edosedgar/ATX_PS/БЛок схема программы.docx

Да

Подключен

аккумулятор?

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
Вывод проблемы

Вариант решения

Выбор мощности

Нажата любая кнопка?

Процент нагрузки максимальный?

Есть отклонения

напряжений?

Увеличить ток

PowerGood OK?

Напряжения ОК?

Сопротивление ОК?

+5 VSB ОК?

Сеть?

Заряжен?

Инициализация
