edosedgar/ATX_PS/Назначение портов.docx

Порт | Назначение
PA10 | PWM12v
PA9 | PWM5v
PA8 | PWM3v3
PA13 | SWDIO
PA14 | SWCLK
PB3 | «OK»
PB5 | «C»
PB6 | LCD_DB4
PB15 | LCD_DB5
PC6 | LCD_DB6
PC7 | LCD_DB7
PB8 | LCD_E
PB9 | LCD_RS
PB11 | UART3_RX
PB10 | UART3_TX
PB0 | BUZZER
PC0 | POWER
PC1 | Current3v3
PC2 | Current5v
PC3 | Current12v
PA0 | PowerGood
PA1 | Volt3v3
PA2 | Volt5v
PA3 | Volt12v
PA4 | StandBy5v
PA5 | PowerON
PA6 | Resistance3v3
PA7 | Resistance12v
PC4 | Resistance5v
PC5 | ReleON
