edosedgar/ATX_PS/Список деталей.docx

№ | Наименование | Стоимость (руб.) | Кол-во (шт.) | Сумма (руб.)
1. | Аккумулятор 12V 0.8A DJW12-0.8 | 470.00 | 1 | 470.00
2. | Аккумулятор ROBITON 12V 0.8A VRLA 1208 | 400.00 | 0 | 0.00
3. | Микросхема ACS712ELCTR-20A-T | 0.00 | 3 | 300.00
4. | Оптрон PC817 C | 8.00 | 4 | 32.00
5. | Транзистор IRLML2502TR smd | 7.00 | 5 | 35.00
6. | Микросхема STM32F100RCT6 smd | 185.00 | 1 | 185.00
7. | Резистор 15Вт 4.7 Ом SQP керамика | 15.00 | 5 | 75.00
8. | Резистор 10Вт 3.3 Ом SQP керамика | 15.00 | 4 | 60.00
9. | Резистор 10Вт 0.99 Ом SQZD керамика | 20.00 | 3 | 60.00
10. | Резистор 5Вт 5.1 Ом SQP керамика | 10.00 | 1 | 10.00
11. | Микросхема FT232BM(BL) smd | 275.00 | 1 | 275.00
12. | Гнездо USBB-1J на плату | 10.00 | 1 | 10.00
13. | Дисплей WG12864 | 650.00 | 1 | 650.00
14. | Кварц 8.0 МГц | 7.00 | 1 | 7.00
15. | Резистор 5Вт 10 Ом SQP керамика | 10.00 | 1 | 10.00
16. | Резистор 5Вт 75 Ом SQP керамика | 15.00 | 1 | 15.00
17. | Резистор 5Вт 39 Ом SQP керамика | 10.00 | 3 | 30.00
18. | Резистор 5Вт 18 Ом SQP керамика | 10.00 | 2 | 20.00
19. | Резистор 5Вт 27 Ом SQP керамика | 15.00 | 1 | 15.00
20. | Транзистор IRFZ44NPBF 60V 50A | 25.00 | 3 | 75.00
21. | Кварц 6.0 МГц усеченный | 15.00 | 1 | 15.00

ИТОГО: 2349.00 руб.

Стеклотекстолит 1-х 200*150 | 60.00 | 2 шт.
Припой ПОС-61 0.8мм 100г без канифоли | 180.00 | 1 шт.
Припой Сплав РОЗЕ 100г | 180.00 | 1 шт.
