edosedgar/ATX_PS/Автоматизированное устройство для тестирования компьютерных блоков питания.pptx

## «Разработка автоматизированного устройства диагностики и тестирования компьютерных блоков питания»

Автор:
Казиахмедов Эдгар Арсенович
Научный руководитель:
Овчинников Владимир Викторович

## Не включается компьютер?

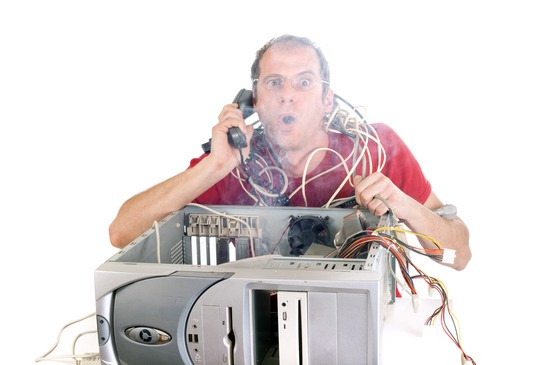
[picture p1: figure]

## Выбросить нельзя, ремонтировать!

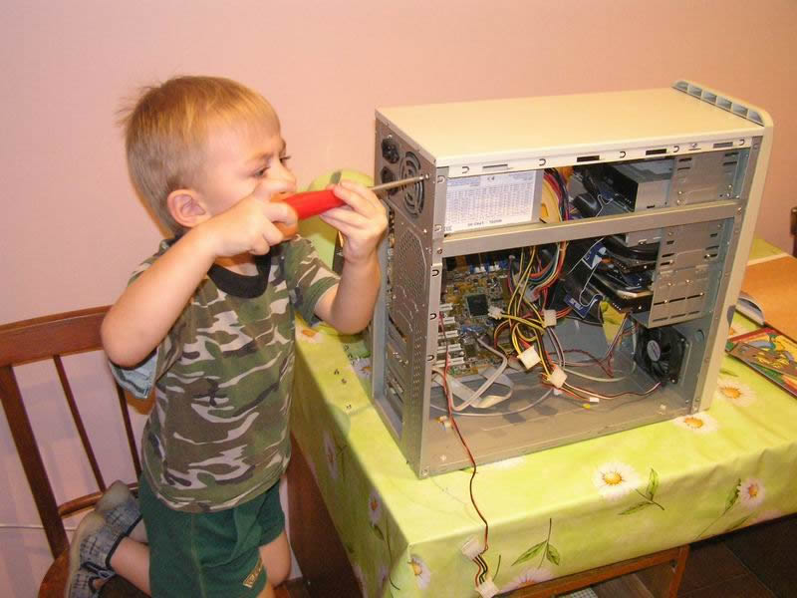
[picture p2: figure]

## Автоматизация ремонта

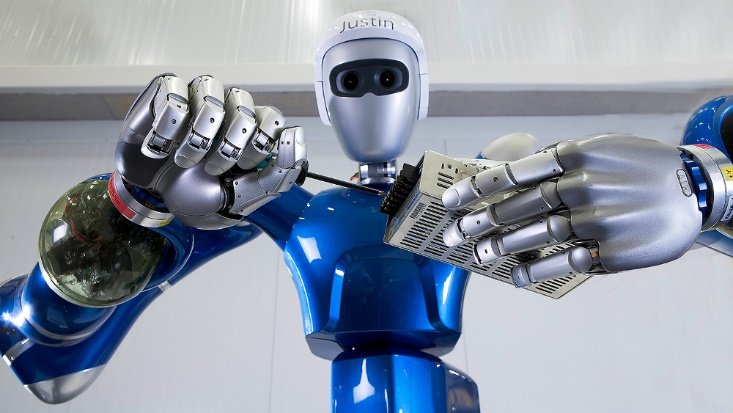
[picture p3: figure]
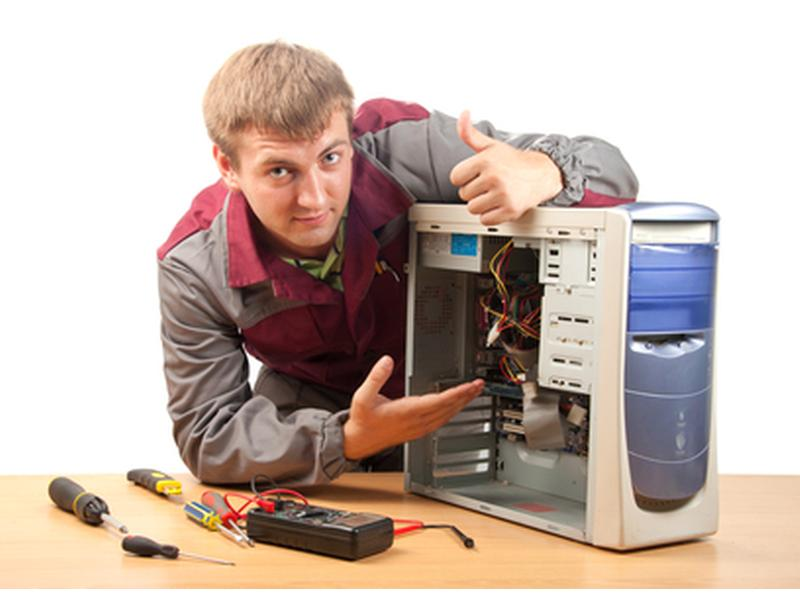
[picture p4: figure]

## Цель

- разработка комплексного устройства, которое сможет в автоматическом режиме провести полную доступную диагностику компьютерного блока питания, выявить его возможные неполадки, а также выполнить тестирование нагрузочной способности.

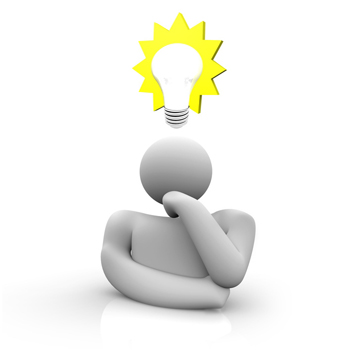
[picture p5: figure]

## Виды неисправностей

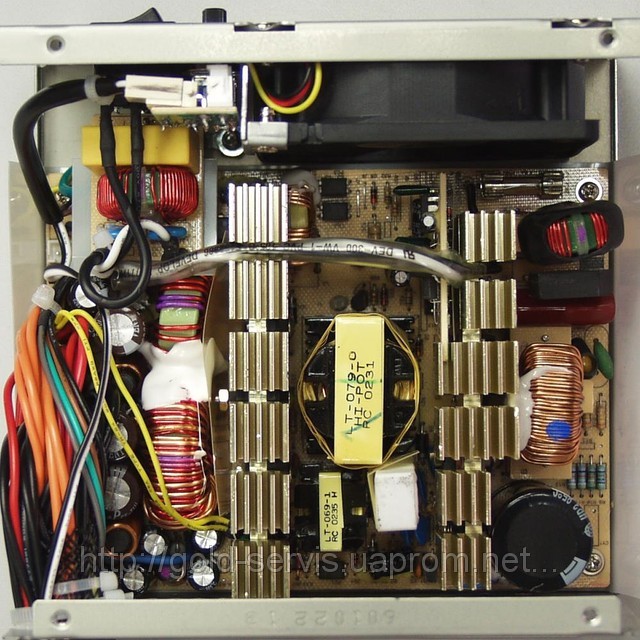
[picture p6: figure]

- Пробой диода
- Высыхание электролитов
- Отклонение напряжений
- Неисправность дежурного питания
- Неисправность в управляющих цепях

## Функциональная схема

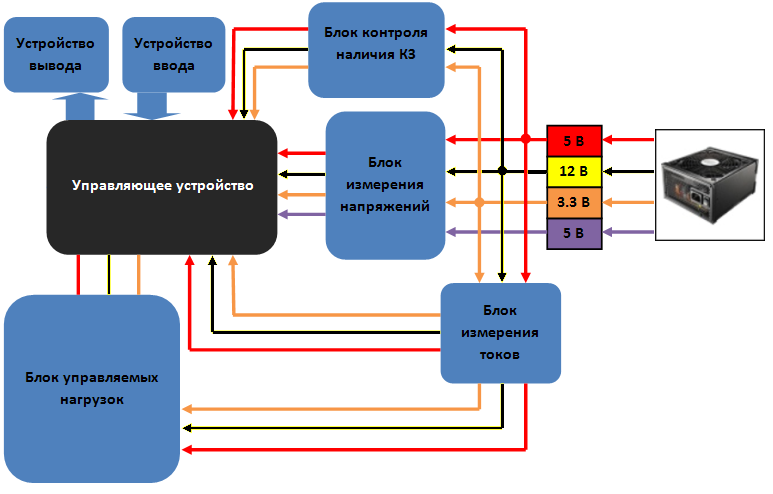
[picture p7: figure]

## Электронная нагрузка

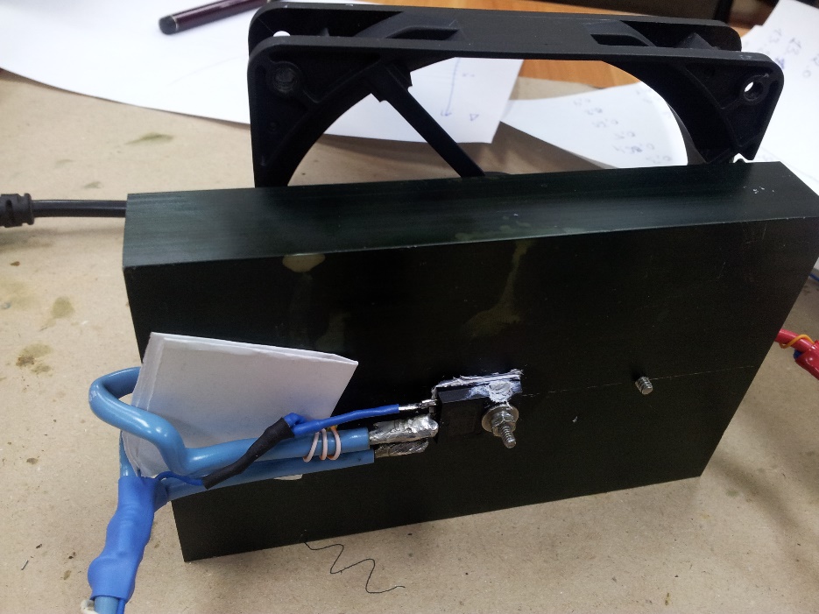
[picture p8: figure]

- Нагрузка на каналы 3,3 В и 5 В:
- Полевые транзисторы IRFZ24N и IRFZ46N
- Рассеиваемая мощность 107 Вт

- Нагрузка на канал 12 В:
- 2 полевых транзистора IRFP064N
- Рассеиваемая мощность 170 Вт

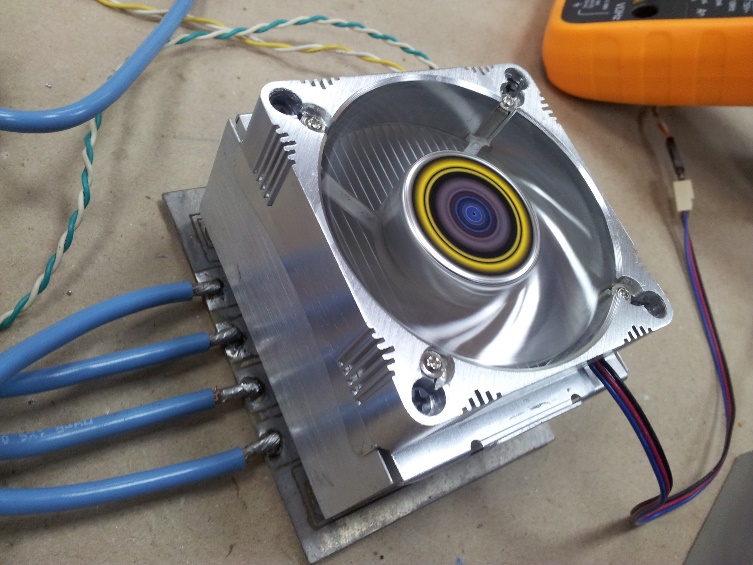
[picture p9: figure]

## Обратная связь

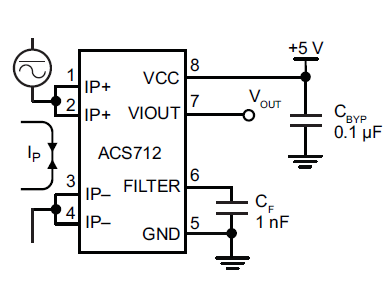
[picture p10: figure]
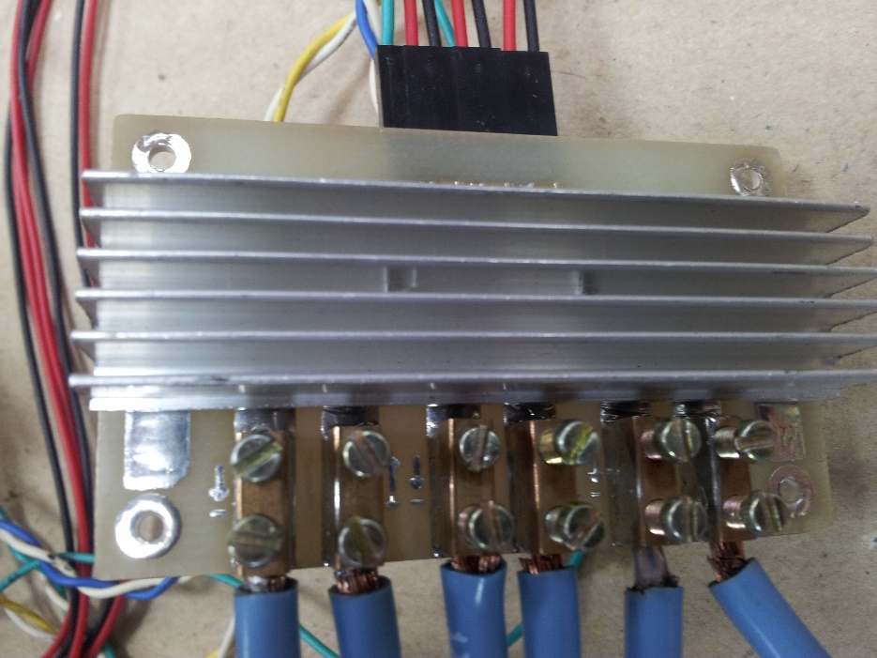
[picture p11: figure]

## Управляющее устройство

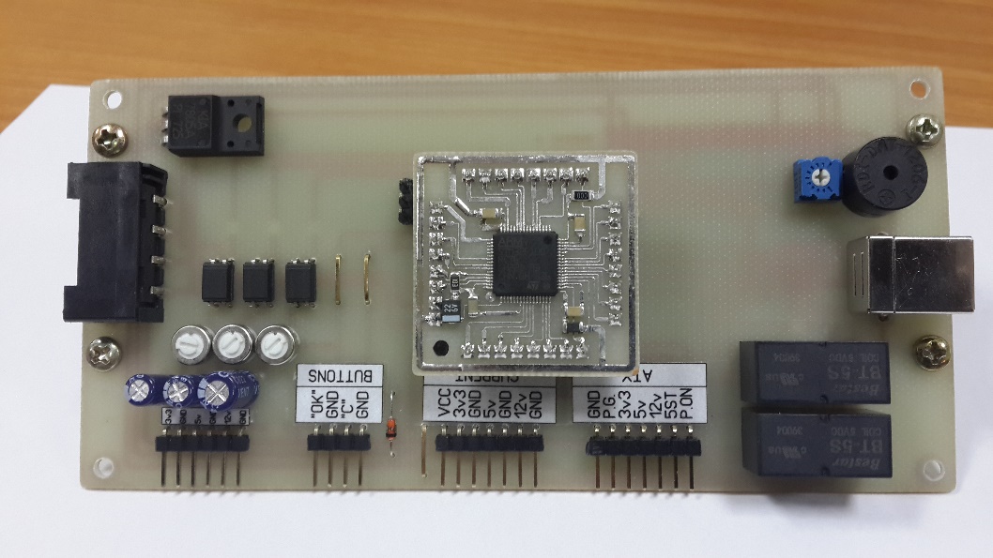
[picture p12: figure]

- Пьезоизлучатель
- ШИМ фильтр
- Разъемы для подключения внешних модулей

- Микроконтроллер STM32F100RC
- Преобразователь USB->USART

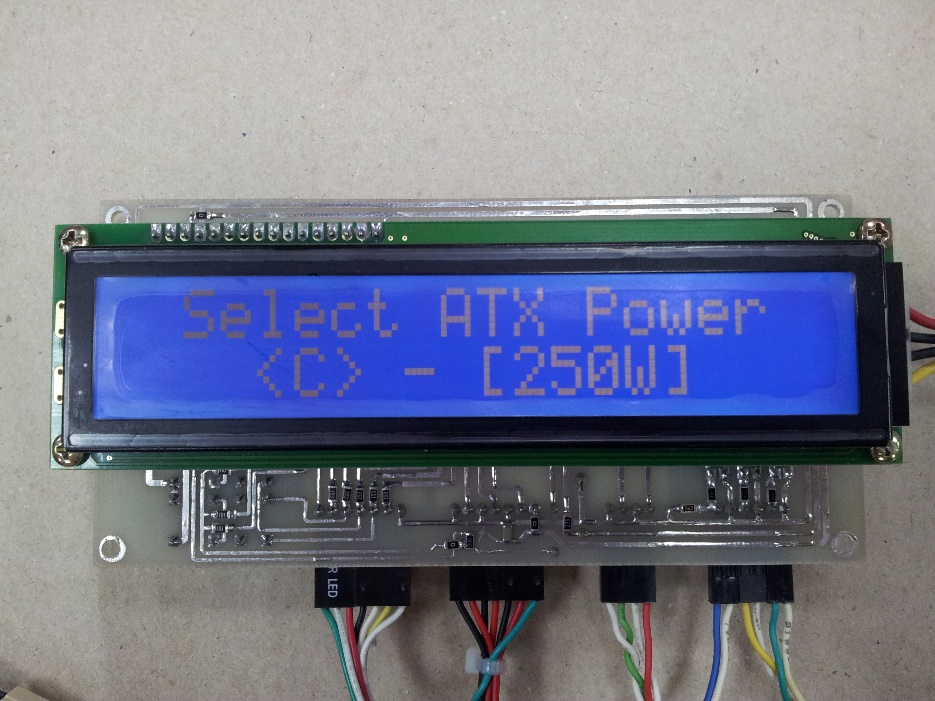
[picture p13: figure]

## Преимущества

- Отсутствии необходимости вмешательства пользователя в процесс тестирования
- Эффективная методика диагностики
- Автономное питание
- Быстрое получение результата

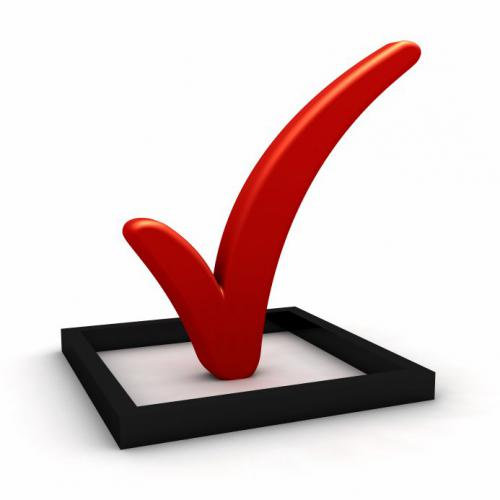
[picture p14: figure]

## Итог

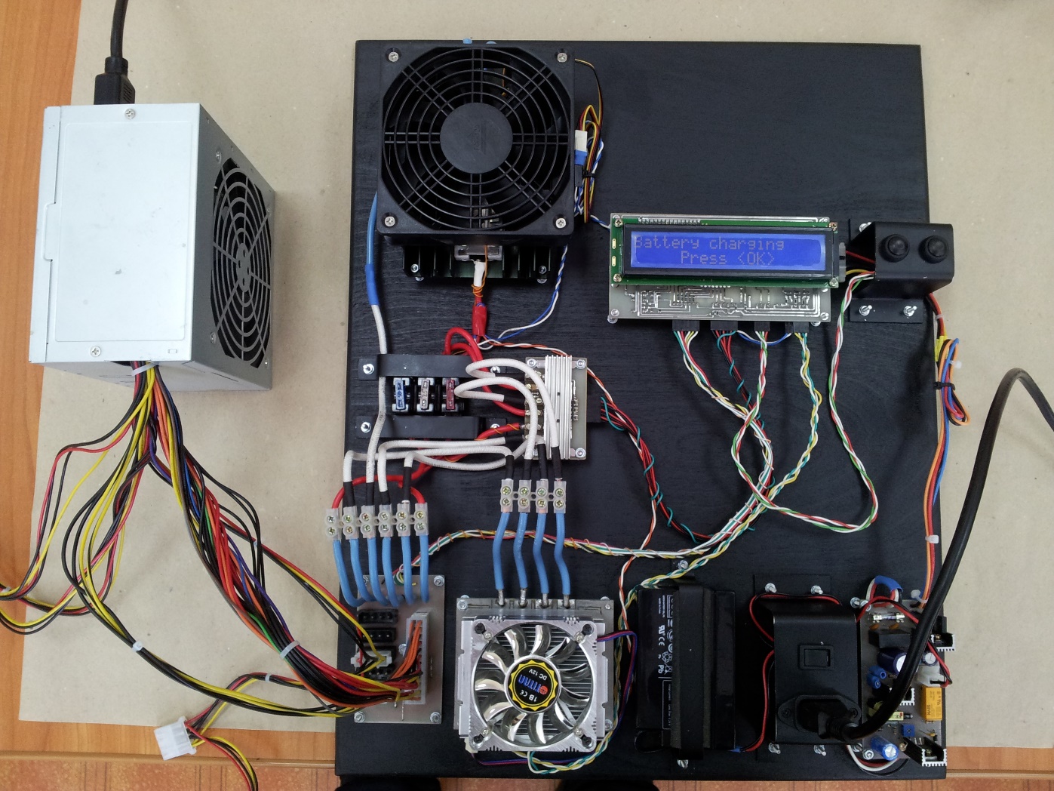
[picture p15: figure]

## Доработка и модернизация

- Реализация возможности загрузки микропрограммы через USB
- Автоматическое отключение питания при разрядке аккумулятора
- Исправление ошибки в схемотехническом решении в цепи управления PowerON
- Улучшение параметров электронных нагрузок

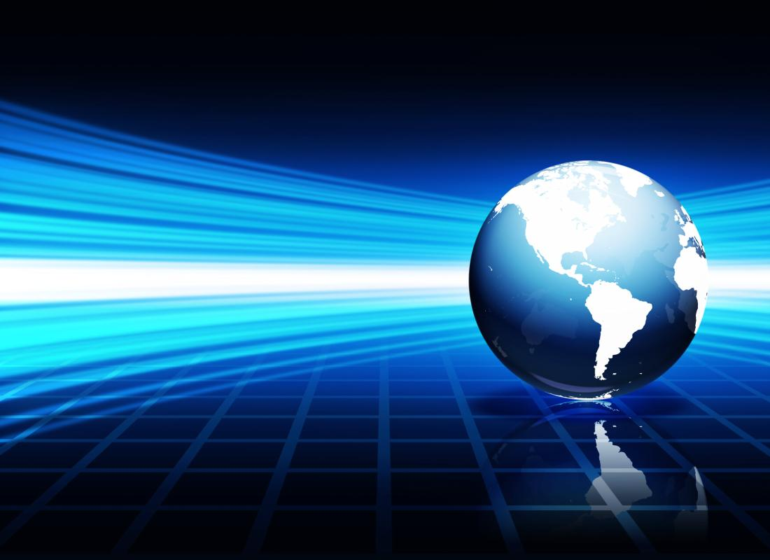
[picture p16: figure]
