edosedgar/ATX_PS/Наклейки на стенд.docx

OK C

БЛОК ПРЕДОХРАНИТЕЛЕЙ

ЭЛЕКТРОННЫЕ НАГРУЗКИ 3,3 В, 5 В

БЕСПЕРЕБОЙНЫЙ ИСТОЧНИК ПИТАНИЯ

УСТРОЙСТВО ВВОДА

УПРАВЛЯЮЩЕЕ УСТРОЙСТВО

ЭЛЕКТРОННАЯ НАГРУЗКА 12 В

БЛОК ИЗМЕРЕНИЯ СИЛЫ ТОКА

«Автоматизированное устройство диагностики и тестирования компьютерных блоков питания»

Автор: Казиахмедов Эдгар Арсенович, 17 лет

Руководитель: Овчинников Владимир Викторович

Учреждение: МБОУДОД ДДЮТ г. Тольятти
