edosedgar/ATX_PS/(list of files, drawings)

Other design files:
PCB/5V; 3,3V channels.lay6
PCB/ACS712.lay6
PCB/ATXBoard.lay6
PCB/GeneralBoard.lay6
PCB/STM32.lay6
PCB/ИБП.lay6
Наклейки.lay6
