edosedgar/ATX_PS/Schemes/Схема ИБП.sch

## EAGLE design Schemes/Схема ИБП.sch (2015-09-19)

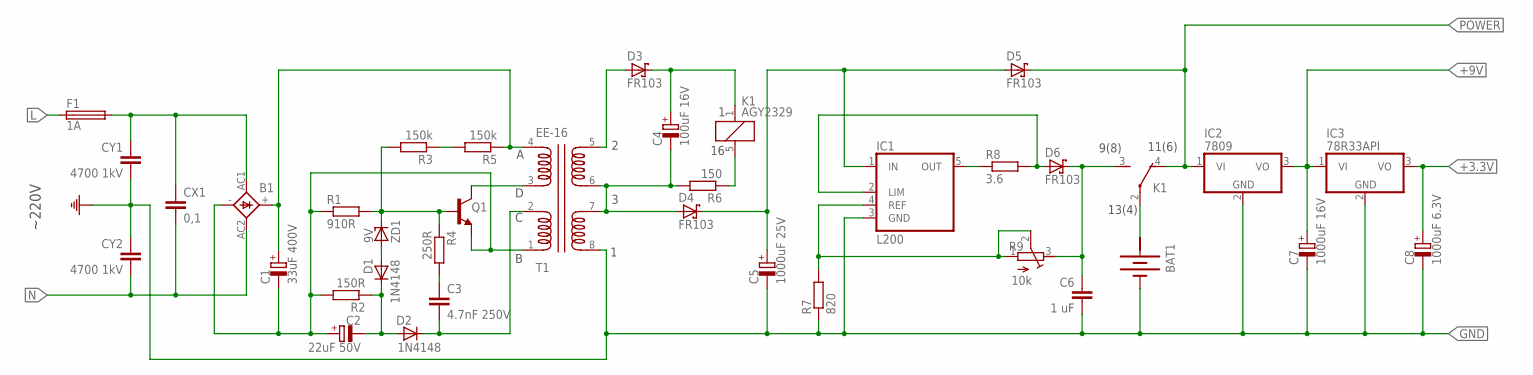
[picture p18: schematic Схема ИБП.sch]

Parts:
B1: 1KAB
BAT1: BATTERY
C1: 33uF 400V; 085CS_1AR
C2: 22uF 50V; 085CS_1AR
C3: 4.7nF 250V; C025-024X044
C4: 100uF 16V; 085CS_1AR
C5: 1000uF 25V; 085CS_1AR
C6: 1 uF; C025-024X044
C7: 1000uF 16V; 085CS_1AR
C8: 1000uF 6.3V; 085CS_1AR
CX1: 0,1; C025-024X044
CY1, CY2: 4700 1kV; C025-024X044
D1, D2: 1N4148; DO41-10
D3, D4, D5, D6: FR103; SOT23
F1: 1А; GSH15
IC1: L200; L200S
IC2: 7809; TO220H
IC3: 78R33API; TO220H
K1: AGY2329; G5SB
Q1: 2N706; TO18
R1: 910R; 0204V
R2: 150R; 0204V
R3, R5: 150k; 0204V
R4: 250R; 0204V
R6: 150; 0204V
R7: 820; 0204V
R8: 3.6; 0204V
R9: 10k; RTRIM4G/J
T1: EE-16; HDS28G2
ZD1: 9V; C1702-15

Connections:
+3.3V: C8.+, IC3.3 (VO)
+9V: C7.+, IC2.3 (VO), IC3.1 (VI)
GND: BAT1.-, C5.-, C6.2, C7.-, C8.-, CY1.2, CY2.1, IC1.3 (GND), IC2.2 (GND), IC3.2 (GND), R7.1, T1.8 (S1.1)
L: F1.1
N: B1.AC2, CX1.2, CY2.2
unnamed: Q1.2 (B), R1.2, R3.2, R4.1, ZD1.C
unnamed: BAT1.+, K1.2
unnamed: C4.-, D4.1 (A), R6.2, T1.6 (S2.1), T1.7 (S1.2)
unnamed: K1.5 (2), R6.1
unnamed: Q1.3 (C), T1.3 (P2.1)
unnamed: B1.-, C1.-, C2.+, Q1.1 (E), R1.1, R2.2, T1.1 (P1.1)
unnamed: R3.1, R5.2
unnamed: C3.2, D2.C, T1.2 (P1.2)
unnamed: C3.1, R4.2
unnamed: D1.A, ZD1.A
unnamed: C6.1, D6.3 (C), K1.3 (S), R9.3 (A)
unnamed: C2.-, D1.C, D2.A, R2.1
unnamed: D3.1 (A), T1.5 (S2.2)
unnamed: C5.+, D4.3 (C), D5.1 (A), IC1.1 (IN)
unnamed: IC1.5 (OUT), R8.1
unnamed: D6.1 (A), IC1.2 (LIM), R8.2
unnamed: B1.+, C1.+, R5.1, T1.4 (P2.2)
unnamed: C4.+, D3.3 (C), K1.1
unnamed: IC1.4 (REF), R7.2, R9.1 (E), R9.2 (S)
unnamed: B1.AC1, CX1.1, CY1.1, F1.2
POWER: D5.3 (C), IC2.1 (VI), K1.4 (O)

Notes on the sheet:
~220V
13(4)
9(8)
11(6)
