edosedgar/ATX_PS/Schemes/Схема датчиков тока.sch

## EAGLE design Schemes/Схема датчиков тока.sch (2015-09-19)

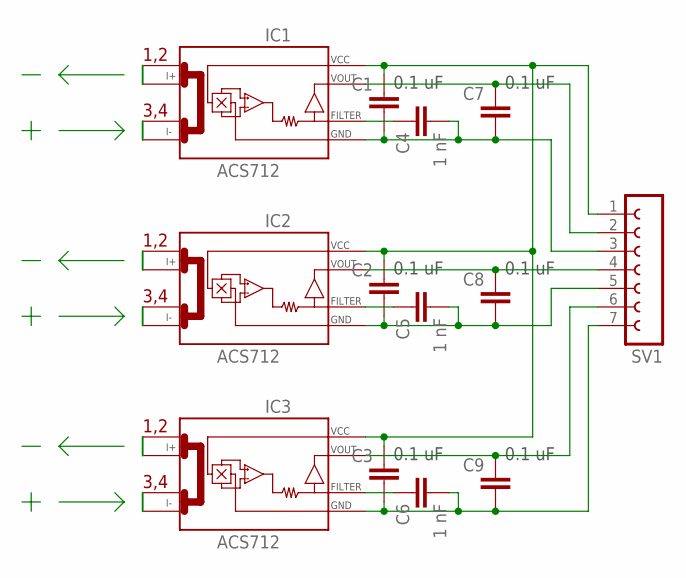
[picture p19: schematic Схема датчиков тока.sch]

Parts:
C1, C2, C3, C7, C8, C9: C-EU025-024X044; C025-024X044
C4, C5, C6: 1 nF; C025-024X044
IC1, IC2, IC3: ACS712; SO08
SV1: FE07-1; FE07

Connections:
unnamed: C4.1, IC1.6 (FILTER)
unnamed: C1.2, C4.2, C7.2, IC1.5 (GND), SV1.3
unnamed: C7.1, IC1.7 (VOUT), SV1.2
unnamed: C1.1, C2.1, C3.1, IC1.8 (VCC), IC2.8 (VCC), IC3.8 (VCC), SV1.1
unnamed: C2.2, C5.2, C8.2, IC2.5 (GND), SV1.5
unnamed: C5.1, IC2.6 (FILTER)
unnamed: C8.1, IC2.7 (VOUT), SV1.4
unnamed: C9.1, IC3.7 (VOUT), SV1.6
unnamed: C3.2, C6.2, C9.2, IC3.5 (GND), SV1.7
unnamed: C6.1, IC3.6 (FILTER)

Notes on the sheet:
0.1 uF
1,2
3,4
