edosedgar/ATX_PS/Schemes/Схема основной платы.sch

## EAGLE design Schemes/Схема основной платы.sch (2015-09-19)

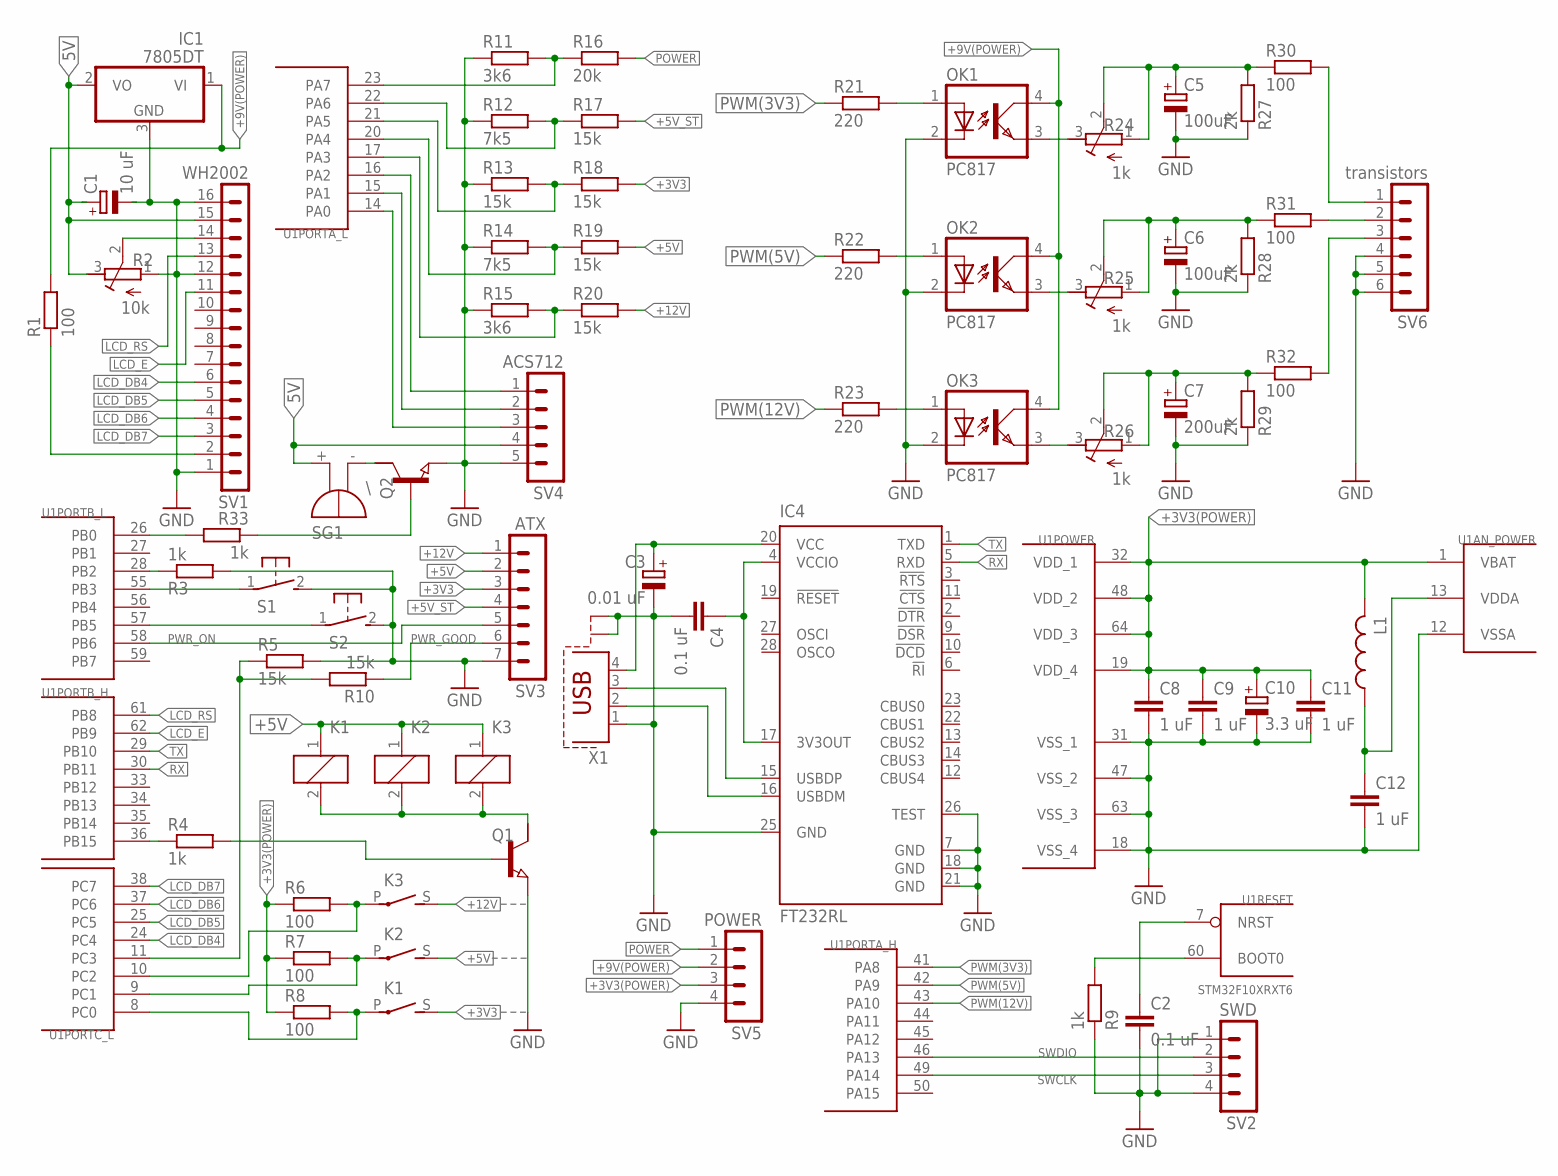
[picture p20: schematic Схема основной платы.sch]

Parts:
C1: 10 uF; 140CLH-0810
C2, C4: 0.1 uF; C1206
C3: 0.01 uF; 140CLH-0810
C5, C6: 100uF; 140CLH-0810
C7: 200uF; 140CLH-0810
C8, C9, C11, C12: 1 uF; C1206
C10: 3.3 uF; 140CLH-0810
IC1: 7805DT; TO252
IC4: FT232RL; SSOP28
K1, K2, K3: G2RA
L1: L-USL1812; L1812
OK1, OK2, OK3: PC817; DIL04
Q1, Q2: NPN-TRANSISTIOR-2COLSOT89; SOT89
R1, R6, R7, R8, R30, R31, R32: 100; M1206
R2: 10k; RTRIM4G/J
R3, R4, R33: 1k; M1206
R5, R10, R13, R17, R18, R19, R20: 15k; M1206
R9: 1k; R1206
R11, R15: 3k6; M1206
R12, R14: 7k5; M1206
R16: 20k; M1206
R21, R22, R23: 220; M1206
R24, R25, R26: 1k; RTRIM4G/J
R27, R28, R29: 2k; M1206
S1, S2: 31-XX; B3F-31XX
SG1: \; F/BC35
SV1: WH2002; MICS-16
SV2: SWD; MA04-1
SV3: ATX; MA07-1
SV4: ACS712; MA05-1
SV5: POWER; MA04-1
SV6: transistors; MA06-1
U1: STM32F10XRXT6; TQFP64
X1: PN61729-S

Connections:
5V: C1.+, IC1.2 (VO), R2.3 (A), SG1.+, SV1.15, SV4.4
12V_RESIST: K3.P, R6.2, U1.10 (PC2)
+3V3: K1.S, R18.2, SV3.3
+3V3(POWER): C8.1, C9.1, C10.+, C11.1, L1.2, SV5.3, U1.1 (VBAT), U1.19 (VDD_4), U1.32 (VDD_1), U1.48 (VDD_2), U1.64 (VDD_3)
+5V: K1.1, K2.1, K2.S, K3.1, R19.2, SV3.2
+5V_ST: R17.2, SV3.4
+9V(POWER): IC1.1 (VI), OK1.4 (COL), OK2.4 (COL), OK3.4 (COL), R1.2, SV5.2
+12V: K3.S, R20.2, SV3.1
GATE1: R30.2, SV6.1
GND: C1.-, C2.2, C3.-, C4.2, C5.-, C6.-, C7.-, C8.2, C9.2, C10.-, C11.2, C12.2, IC1.3 (GND), IC4.7 (GND), IC4.18 (GND), IC4.21 (GND), IC4.25 (GND), IC4.26 (TEST), OK1.2 (C), OK2.2 (C), OK3.2 (C), Q1.3 (E), Q2.3 (E), R2.1 (E), R3.2, R5.2, R9.1, R11.1, R12.1, R13.1, R14.1, R15.1, R27.1, R28.1, R29.1, S1.2 (S), S2.2 (S), SV1.1, SV1.12, SV1.16, SV2.1, SV2.4, SV3.7, SV4.5, SV5.4, SV6.4, SV6.5, SV6.6, U1.12 (VSSA), U1.18 (VSS_4), U1.31 (VSS_1), U1.47 (VSS_2), U1.63 (VSS_3), X1.1, X1.S1, X1.S2
LCD_DB4: SV1.6, U1.24 (PC4)
LCD_DB5: SV1.5, U1.25 (PC5)
LCD_DB6: SV1.4, U1.37 (PC6)
LCD_DB7: SV1.3, U1.38 (PC7)
LCD_E: SV1.11, U1.62 (PB9)
LCD_RS: SV1.13, U1.61 (PB8)
unnamed: C3.+, IC4.20 (VCC), X1.4
unnamed: R3.1, U1.28 (PB2)
unnamed: S1.1, U1.55 (PB3)
unnamed: S2.1, U1.57 (PB5)
unnamed: R2.2 (S), SV1.14
unnamed: C4.1, IC4.4 (VCCIO), IC4.17 (3V3OUT)
unnamed: R1.1, SV1.2
unnamed: R5.1, R10.2, U1.11 (PC3)
unnamed: R9.2, U1.60 (BOOT0)
unnamed: C2.1, U1.7 (NRST)
unnamed: Q2.2 (C), SG1.-
unnamed: SV4.1, U1.16 (PA2)
unnamed: K1.P, R8.2, U1.8 (PC0)
unnamed: SV4.2, U1.15 (PA1)
unnamed: IC4.15 (USBDP), X1.3
unnamed: IC4.16 (USBDM), X1.2
unnamed: SV4.3, U1.14 (PA0)
unnamed: C12.1, L1.1, U1.13 (VDDA)
unnamed: C5.+, R24.1 (E), R24.2 (S), R27.2, R30.1
unnamed: OK2.3 (EMIT), R25.3 (A)
unnamed: R33.2, U1.26 (PB0)
unnamed: K2.P, R7.2, U1.9 (PC1)
unnamed: C6.+, R25.1 (E), R25.2 (S), R28.2, R31.1
unnamed: OK3.3 (EMIT), R26.3 (A)
unnamed: R4.1, U1.36 (PB15)
unnamed: Q2.1 (B), R33.1
unnamed: C7.+, R26.1 (E), R26.2 (S), R29.2, R32.1
unnamed: R32.2, SV6.3
unnamed: R31.2, SV6.2
unnamed: Q1.1 (B), R4.2
unnamed: K1.2, K2.2, K3.2, Q1.2 (C)
unnamed: R6.1, R7.1, R8.1
unnamed: OK1.1 (A), R21.2
unnamed: OK2.1 (A), R22.2
unnamed: OK3.1 (A), R23.2
unnamed: OK1.3 (EMIT), R24.3 (A)
POWER: R16.2, SV5.1
PWM(3V3): R21.1, U1.41 (PA8)
PWM(5V): R22.1, U1.42 (PA9)
PWM(12V): R23.1, U1.43 (PA10)
PWR_GOOD: R10.1, SV3.6
PWR_ON: SV3.5, U1.58 (PB6)
RX: IC4.5 (RXD), U1.30 (PB11)
SWCLK: SV2.3, U1.49 (PA14)
SWDIO: SV2.2, U1.46 (PA13)
TX: IC4.1 (TXD), U1.29 (PB10)
VOLTAGE(3V3): R13.2, R18.1, U1.21 (PA5)
VOLTAGE(5V): R14.2, R19.1, U1.20 (PA4)
VOLTAGE(5VST): R12.2, R17.1, U1.22 (PA6)
VOLTAGE(12POWER): R11.2, R16.1, U1.23 (PA7)
VOLTAGE(12V): R15.2, R20.1, U1.17 (PA3)
