edosedgar/ATX_PS/STM32Program/V2.1/InitPeripheral.c

#include <stm32f10x_rcc.h>
#include <stm32f10x_gpio.h>
#include <stm32f10x_flash.h>
#include <stm32f10x_adc.h>
#include <stm32f10x_tim.h>
#include <stm32f10x_spi.h>
#include <stm32f10x_dma.h>
#include <misc.h>

uint16_t ADCBuffer[] = {0x0000, 0x0000, 0x0000, 0x0000, 0x0000, 0x0000, 0x0000, 0x0000, 0x0000, 0x0000, 0x0000, 0x0000};
//Array defines
#define Current12V 			ADCBuffer[0]
#define Current5V  			ADCBuffer[1]
#define Current3V3 			ADCBuffer[2]
#define Resistance12V 		ADCBuffer[5]
#define Resistance5V  		ADCBuffer[4]
#define Resistance3V3 		ADCBuffer[3]
#define Voltage12V 		 	ADCBuffer[6]
#define Voltage5V  		 	ADCBuffer[7]
#define Voltage3V3 		 	ADCBuffer[8]
#define Voltage5ST 		 	ADCBuffer[9]
#define PowerVoltage 	 	ADCBuffer[10]
#define PowerGoodVoltage 	ADCBuffer[11]

//===============================================
void RCC_Configuration(void);
void ADC_Configuration(void);
void GPIO_Configuration(void);
void TIM_Configuration(void);
void DMA_Configuration(void);
//===============================================
void RCC_Configuration(void)
{
	FLASH_PrefetchBufferCmd(ENABLE);
	FLASH_SetLatency(FLASH_ACR_LATENCY_1);
    RCC_DeInit();
    RCC_HSICmd(ENABLE);
	RCC_HCLKConfig(RCC_SYSCLK_Div1);
	RCC_PCLK1Config(RCC_HCLK_Div1);
	RCC_PCLK2Config(RCC_HCLK_Div1);
	RCC_ADCCLKConfig(RCC_PCLK2_Div6);
	RCC_PLLConfig(RCC_PLLSource_HSI_Div2, RCC_PLLMul_6);
	RCC_PLLCmd(ENABLE);
	/* Wait till PLL is ready */
	while (RCC_GetFlagStatus(RCC_FLAG_PLLRDY) == RESET) {}
	/* Select PLL as system clock source */
	RCC_SYSCLKConfig(RCC_SYSCLKSource_PLLCLK);
	/* Wait till PLL is used as system clock source */
	while (RCC_GetSYSCLKSource() != 0x08) {};
};

void TIM_Configuration(void)
{
	TIM_TimeBaseInitTypeDef  TIM_TimeBaseStructure;
	TIM_OCInitTypeDef TIM_OCInitStructure;
	NVIC_InitTypeDef NVIC_InitStructure;
	RCC_APB1PeriphClockCmd(RCC_APB1Periph_TIM6 | RCC_APB1Periph_TIM7 | RCC_APB1Periph_TIM2, ENABLE);
	RCC_APB2PeriphClockCmd(RCC_APB2Periph_TIM1, ENABLE);
	/* Enable the TIM6 global Interrupt */
	NVIC_InitStructure.NVIC_IRQChannel = TIM6_DAC_IRQn;
	NVIC_InitStructure.NVIC_IRQChannelSubPriority = 2;
	NVIC_InitStructure.NVIC_IRQChannelCmd = ENABLE;
	NVIC_Init(&NVIC_InitStructure);
	NVIC_InitStructure.NVIC_IRQChannel = TIM7_IRQn;
	NVIC_InitStructure.NVIC_IRQChannelSubPriority =0;
	NVIC_InitStructure.NVIC_IRQChannelCmd = ENABLE;
	NVIC_Init(&NVIC_InitStructure);
	NVIC_InitStructure.NVIC_IRQChannel = TIM2_IRQn;
	NVIC_InitStructure.NVIC_IRQChannelSubPriority =0;
	NVIC_InitStructure.NVIC_IRQChannelCmd = ENABLE;
	NVIC_Init(&NVIC_InitStructure);

//==============================================================================

	TIM_DeInit(TIM1);
	/* Time base configuration */
	TIM_TimeBaseStructure.TIM_Period = 2999;
	TIM_TimeBaseStructure.TIM_Prescaler = 7;
	TIM_TimeBaseStructure.TIM_ClockDivision = 0x00;
	TIM_TimeBaseStructure.TIM_CounterMode = TIM_CounterMode_Up;
	TIM_TimeBaseInit(TIM1, &TIM_TimeBaseStructure);

	/* Channel 1, 2, 3 Configuration in PWM mode */
	TIM_OCInitStructure.TIM_OCMode = TIM_OCMode_PWM1;
	TIM_OCInitStructure.TIM_OutputState = TIM_OutputState_Enable;
	TIM_OCInitStructure.TIM_Pulse = 0;
	TIM_OCInitStructure.TIM_OCPolarity = TIM_OCPolarity_High;
	TIM_OC1Init(TIM1, &TIM_OCInitStructure);
	TIM_OC2Init(TIM1, &TIM_OCInitStructure);
	TIM_OC3Init(TIM1, &TIM_OCInitStructure);


	/* TIM3 Enable */
	TIM_Cmd(TIM1, ENABLE);
	TIM_CtrlPWMOutputs(TIM1, ENABLE);

//==============================================================================

	/* Time base configuration */
	TIM_TimeBaseStructure.TIM_Period = 10;
	TIM_TimeBaseStructure.TIM_Prescaler = 2399;
	TIM_TimeBaseStructure.TIM_ClockDivision = 0;
	TIM_TimeBaseStructure.TIM_CounterMode = TIM_CounterMode_Up;
	TIM_TimeBaseInit(TIM6, &TIM_TimeBaseStructure);
	/* Clear TIM2 update pending flags */
	TIM_ClearFlag(TIM6, TIM_FLAG_Update);
	/* TIM Interrupts enable */
	TIM_ITConfig(TIM6, TIM_IT_Update, ENABLE);
	/* TIM6 enable counter */
    TIM_Cmd(TIM6, ENABLE);

//==============================================================================

	/* Time base configuration */
	TIM_TimeBaseStructure.TIM_Period = 2;
	TIM_TimeBaseStructure.TIM_Prescaler = 23999;
	TIM_TimeBaseStructure.TIM_ClockDivision = 0;
	TIM_TimeBaseStructure.TIM_CounterMode = TIM_CounterMode_Up;
	TIM_TimeBaseInit(TIM7, &TIM_TimeBaseStructure);
	/* Clear TIM2 update pending flags */
	TIM_ClearFlag(TIM7, TIM_FLAG_Update);
	/* TIM Interrupts enable */
	TIM_ITConfig(TIM7, TIM_IT_Update, ENABLE);
	/* TIM7 enable counter */
	TIM_Cmd(TIM7, ENABLE);

//==============================================================================

	/* Time base configuration */
	TIM_TimeBaseStructure.TIM_Period = 5;
	TIM_TimeBaseStructure.TIM_Prescaler = 2399;
	TIM_TimeBaseStructure.TIM_ClockDivision = 0;
	TIM_TimeBaseStructure.TIM_CounterMode = TIM_CounterMode_Up;
	TIM_TimeBaseInit(TIM2, &TIM_TimeBaseStructure);
	/* Clear TIM2 update pending flags */
	TIM_ClearFlag(TIM2, TIM_FLAG_Update);
	/* TIM Interrupts enable */
	TIM_ITConfig(TIM2, TIM_IT_Update, ENABLE);
	/* TIM2 enable counter */
	TIM_Cmd(TIM2, ENABLE);

//==============================================================================
};

void ADC_Configuration(void)
{
	ADC_InitTypeDef ADC_InitStructure;
	ADC_DeInit(ADC1);
	RCC_APB2PeriphClockCmd(RCC_APB2Periph_ADC1, ENABLE);
	ADC_InitStructure.ADC_ContinuousConvMode = ENABLE;
	ADC_InitStructure.ADC_DataAlign = ADC_DataAlign_Right;
	ADC_InitStructure.ADC_ExternalTrigConv = ADC_ExternalTrigConv_None;
	ADC_InitStructure.ADC_Mode = ADC_Mode_Independent;
	ADC_InitStructure.ADC_NbrOfChannel = 12;
	ADC_InitStructure.ADC_ScanConvMode = ENABLE;
	ADC_Init(ADC1, &ADC_InitStructure);
	/* Convert the ADC1 Channel 11 with 239.5 Cycles as sampling time */
	//ACS712 0-2.5 V
	ADC_RegularChannelConfig(ADC1, ADC_Channel_13, 1, ADC_SampleTime_239Cycles5); //12
	ADC_RegularChannelConfig(ADC1, ADC_Channel_12, 2, ADC_SampleTime_239Cycles5); //5
	ADC_RegularChannelConfig(ADC1, ADC_Channel_11, 3, ADC_SampleTime_239Cycles5); //3.3
	//Resistance
	ADC_RegularChannelConfig(ADC1, ADC_Channel_6, 4, ADC_SampleTime_239Cycles5); //3.3
	ADC_RegularChannelConfig(ADC1, ADC_Channel_14, 5, ADC_SampleTime_239Cycles5); //5
	ADC_RegularChannelConfig(ADC1, ADC_Channel_7, 6, ADC_SampleTime_239Cycles5); //12
	//Voltmetr
	ADC_RegularChannelConfig(ADC1, ADC_Channel_3, 7, ADC_SampleTime_239Cycles5); //12
	ADC_RegularChannelConfig(ADC1, ADC_Channel_2, 8, ADC_SampleTime_239Cycles5); //5
	ADC_RegularChannelConfig(ADC1, ADC_Channel_1, 9, ADC_SampleTime_239Cycles5); //3.3
	ADC_RegularChannelConfig(ADC1, ADC_Channel_4, 10,ADC_SampleTime_239Cycles5);//5 ST
	ADC_RegularChannelConfig(ADC1, ADC_Channel_10, 11,ADC_SampleTime_239Cycles5);//POWER
	ADC_RegularChannelConfig(ADC1, ADC_Channel_0,12,ADC_SampleTime_239Cycles5);//Power good
	/* Enable ADCperipheral */
	ADC_Cmd(ADC1, ENABLE);
	ADC_DMACmd(ADC1, ENABLE);
	ADC_ResetCalibration(ADC1);
	//while(ADC_GetResetCalibrationStatus(ADC1));
	ADC_StartCalibration(ADC1);
	//while(ADC_GetCalibrationStatus(ADC1));
	ADC_SoftwareStartConvCmd(ADC1,ENABLE);
};

void DMA_Configuration(void)
{
	DMA_InitTypeDef DMA_InitStructure;
	RCC_AHBPeriphClockCmd(RCC_AHBPeriph_DMA1 , ENABLE) ;
	DMA_InitStructure.DMA_BufferSize= 12;
	DMA_InitStructure.DMA_DIR = DMA_DIR_PeripheralSRC;
	DMA_InitStructure.DMA_M2M = DMA_M2M_Disable;
	DMA_InitStructure.DMA_MemoryBaseAddr = (uint32_t)ADCBuffer;
	DMA_InitStructure.DMA_MemoryDataSize = DMA_MemoryDataSize_HalfWord;
	DMA_InitStructure.DMA_MemoryInc = DMA_MemoryInc_Enable;
	DMA_InitStructure.DMA_Mode = DMA_Mode_Circular;
	DMA_InitStructure.DMA_PeripheralBaseAddr = (uint32_t)&ADC1->DR;
	DMA_InitStructure.DMA_PeripheralDataSize = DMA_PeripheralDataSize_HalfWord;
	DMA_InitStructure.DMA_PeripheralInc = DMA_PeripheralInc_Disable;
	DMA_InitStructure.DMA_Priority = DMA_Priority_High;
	DMA_Init(DMA1_Channel1, &DMA_InitStructure);
	DMA_Cmd(DMA1_Channel1, ENABLE);
}

void GPIO_Configuration(void)
{
	GPIO_InitTypeDef GPIO_InitStructure;
	RCC_APB2PeriphClockCmd (RCC_APB2Periph_GPIOA|RCC_APB2Periph_GPIOC|RCC_APB2Periph_GPIOB|RCC_APB2Periph_AFIO,ENABLE);
	GPIO_PinRemapConfig (GPIO_Remap_SWJ_JTAGDisable, ENABLE);
	GPIO_PinRemapConfig (GPIO_FullRemap_TIM3, ENABLE);
	// PWM Port Init
	GPIO_InitStructure.GPIO_Pin   = GPIO_Pin_8 | GPIO_Pin_9 | GPIO_Pin_10;
	GPIO_InitStructure.GPIO_Speed = GPIO_Speed_50MHz;
	GPIO_InitStructure.GPIO_Mode = GPIO_Mode_AF_PP;
	GPIO_Init(GPIOA, &GPIO_InitStructure);
	// ADC Port Init
	GPIO_InitStructure.GPIO_Pin = GPIO_Pin_0 | GPIO_Pin_1 | GPIO_Pin_2 | GPIO_Pin_3 | GPIO_Pin_4;
	GPIO_InitStructure.GPIO_Mode = GPIO_Mode_AIN;
	GPIO_InitStructure.GPIO_Speed = GPIO_Speed_50MHz;
	GPIO_Init (GPIOC, &GPIO_InitStructure);
	GPIO_InitStructure.GPIO_Pin = GPIO_Pin_0 | GPIO_Pin_1 | GPIO_Pin_2 | GPIO_Pin_3 | GPIO_Pin_4 | GPIO_Pin_6 | GPIO_Pin_7;
	GPIO_InitStructure.GPIO_Mode = GPIO_Mode_AIN;
	GPIO_InitStructure.GPIO_Speed = GPIO_Speed_50MHz;
	GPIO_Init (GPIOA, &GPIO_InitStructure);
	// LCD Port Init
    GPIO_InitStructure.GPIO_Speed = GPIO_Speed_50MHz;
    GPIO_InitStructure.GPIO_Mode  = GPIO_Mode_Out_PP;
    GPIO_InitStructure.GPIO_Pin   = GPIO_Pin_8 | GPIO_Pin_9 | GPIO_Pin_15 | GPIO_Pin_6;
    GPIO_Init (GPIOB, &GPIO_InitStructure);
    GPIO_InitStructure.GPIO_Speed = GPIO_Speed_50MHz;
    GPIO_InitStructure.GPIO_Mode  = GPIO_Mode_Out_PP;
    GPIO_InitStructure.GPIO_Pin   = GPIO_Pin_6 | GPIO_Pin_7;
    GPIO_Init (GPIOC, &GPIO_InitStructure);
	// Buttons Port Init
	GPIO_InitStructure.GPIO_Pin = GPIO_Pin_3 | GPIO_Pin_5;
	GPIO_InitStructure.GPIO_Mode = GPIO_Mode_IPU;
	GPIO_Init (GPIOB, &GPIO_InitStructure);
	// PowerOn Init
	GPIO_InitStructure.GPIO_Pin = GPIO_Pin_5;
	GPIO_InitStructure.GPIO_Mode = GPIO_Mode_Out_PP;
	GPIO_Init (GPIOA, &GPIO_InitStructure);
	GPIO_WriteBit(GPIOA,GPIO_Pin_5,Bit_SET);
	// ReleON Init
	GPIO_InitStructure.GPIO_Pin = GPIO_Pin_5;
	GPIO_InitStructure.GPIO_Mode = GPIO_Mode_Out_PP;
	GPIO_Init (GPIOC, &GPIO_InitStructure);
	GPIO_WriteBit(GPIOC,GPIO_Pin_5,Bit_SET);
	// Buzzer Init
	GPIO_InitStructure.GPIO_Pin = GPIO_Pin_0;
	GPIO_InitStructure.GPIO_Mode = GPIO_Mode_Out_PP;
	GPIO_Init (GPIOB, &GPIO_InitStructure);
};
