edosedgar/ATX_PS/STM32Program/V2.1/Structures.c

typedef struct
{
	uint16_t VZero;
	uint16_t MinCurrentDetect;
	uint16_t ZeroCurrent;
	uint16_t R1;
	uint16_t R2;
	uint16_t PWM;
	uint32_t I_Real;
	uint32_t I_Ideal;
	uint32_t IBuffer;
	uint32_t V_Real;
	uint32_t VBuffer;
} TChannel3V3;

typedef struct
{
	uint16_t VZero;
	uint16_t MinCurrentDetect;
	uint16_t ZeroCurrent;
	uint16_t R1;
	uint16_t R2;
	uint16_t PWM;
	uint32_t I_Real;
	uint32_t I_Ideal;
	uint32_t IBuffer;
	uint32_t V_Real;
	uint32_t VBuffer;
} TChannel5V;

typedef struct
{
	uint16_t VZero;
	uint16_t MinCurrentDetect;
	uint16_t ZeroCurrent;
	uint16_t R1;
	uint16_t R2;
	uint16_t PWM;
	uint32_t I_Real;
	uint32_t I_Ideal;
	uint32_t IBuffer;
	uint32_t V_Real;
	uint32_t VBuffer;
} TChannel12V;

typedef struct
{
	uint16_t R1;
	uint16_t R2;
	uint32_t V_Real;
	uint32_t VBuffer;
	uint8_t  PowerTest;
} TPower;

typedef struct
{
	uint16_t R1;
	uint16_t R2;
	uint32_t V_Real;
	uint32_t VBuffer;
	uint16_t IsCountTimeOn;
	uint16_t TimeOn;
	uint8_t  Monitoring;
} TPOK;

typedef struct
{
	uint16_t R1;
	uint16_t R2;
	uint32_t V_Real;
	uint32_t VBuffer;
} TChannel5VSB;

typedef struct
{
	uint16_t PSUPower;
	uint32_t CounterVolts;
	uint32_t CounterAmps;
	uint8_t  IsRefreshLCD;
	uint16_t Wait10ms;
	uint8_t  ShowingCharging;
	uint8_t  TimerOn;
	uint8_t  DelayScenario;
	uint8_t  IsControlCurrent;
	uint8_t  PercentLoad;
	uint16_t IsTestStarted;
} TSystemSettings;

typedef struct
{
	uint8_t OK;
	uint8_t C;
	uint8_t B1;
	uint8_t B2;
	uint8_t CounterB1;
	uint8_t CounterB2;
} TButton;

typedef struct
{
	uint8_t State1;
	uint8_t State2;
	uint8_t State3;
	uint8_t Counter;
} TBeep;

typedef enum
{
	scLogo,
	scPreSupply,
	scBatterySupply,
	scACSupply,
	scWaiting,
	scBattteryCharging,
	scSelectATXPower,
	scPreTest,
	scTest,
	scLowBattery,
	scWaitACPower,
	scExitTest,
	scPreVSBTest,
	scVSBTest,
	scVSBTestFail,
	scPreImpedanceTest,
	scImpedanceTest,
	scFailImpedanceTest,
	scFailImpedanceTestAdvice,
	scPrePowerGoodTest,
	scPowerGoodTest,
	scFailPowerGoodTest,
	scFailPowerGoodTestAdvice,
	scVanishPowerGood,
	scPreVoltageTest,
	scVoltageTest,
	scFailVoltageTest,
	scFailVoltageTestAdvice,
	scPreLoadTest,
	scLoadTest,
	scFailLoadTest,
	scFailLoadTestAdvice,
	scATX_OK,
	scFailPowerONTest,
	scFailPowerONTestAdvice,
	scTestCompleted,
	scTestAborted,
	scBeepTestPASSED,
	scBeepTestFAILED
} TScenario;
//*******************************************************************
void FullReset(void);
//*******************************************************************
TChannel3V3  	Channel3V3;
TChannel5V   	Channel5V;
TChannel12V  	Channel12V;
TPower 	    	Power;
TPOK		    PowerOK;
TChannel5VSB	Channel5VSB;
TSystemSettings SystemSettings;
TButton			Button;
TScenario Scenario,PostScenario;
TBeep			Beep;

//*******************************************************************
void FullReset(void)
{
	//Init Struct Channel3V3
	Channel3V3.VZero=2520;
	Channel3V3.MinCurrentDetect=3110;
	Channel3V3.ZeroCurrent=3127;
	Channel3V3.R1=14990;
	Channel3V3.R2=14990;
	Channel3V3.PWM=0;
	Channel3V3.I_Ideal=Channel3V3.ZeroCurrent;
	Channel3V3.I_Real=Channel3V3.I_Ideal;
	Channel3V3.IBuffer=0;
	Channel3V3.V_Real=0;
	Channel3V3.VBuffer=0;

	//Init Struct Channel5V
	Channel5V.VZero=2517;
	Channel5V.MinCurrentDetect=3110;
	Channel5V.ZeroCurrent=3123;
	Channel5V.R1=14955;
	Channel5V.R2=7460;
	Channel5V.PWM=0;
	Channel5V.I_Ideal=Channel5V.ZeroCurrent;
	Channel5V.I_Real=Channel5V.I_Ideal;
	Channel5V.IBuffer=0;
	Channel5V.V_Real=0;
	Channel5V.VBuffer=0;

	//Init Struct Channel12V
	Channel12V.VZero=2513;
	Channel12V.MinCurrentDetect=3100;
	Channel12V.ZeroCurrent=3118;
	Channel12V.R1=15020;
	Channel12V.R2=3570;
	Channel12V.PWM=0;
	Channel12V.I_Ideal=Channel12V.ZeroCurrent;
	Channel12V.I_Real=Channel12V.I_Ideal;
	Channel12V.IBuffer=0;
	Channel12V.V_Real=0;
	Channel12V.VBuffer=0;

	//Init Struct Power
	Power.R1=27100;
	Power.R2=3590;
	Power.V_Real=0;
	Power.VBuffer=0;
	Power.PowerTest=0;

	//Init Struct PowerOK
	PowerOK.R1=15000;
	PowerOK.R2=15000;
	PowerOK.V_Real=0;
	PowerOK.VBuffer=0;
	PowerOK.TimeOn=0;
	PowerOK.Monitoring=0;
	PowerOK.IsCountTimeOn=0;

	//Init Struct Channel5VSB
	Channel5VSB.R1=15100;
	Channel5VSB.R2=7510;
	Channel5VSB.V_Real=0;
	Channel5VSB.VBuffer=0;

	//Init System settings
	SystemSettings.PSUPower=250;
	SystemSettings.CounterAmps=0;
	SystemSettings.CounterVolts=0;
	SystemSettings.IsRefreshLCD=0;
	SystemSettings.Wait10ms=0;
	SystemSettings.ShowingCharging=0;
	SystemSettings.TimerOn=0;
	SystemSettings.DelayScenario=0;
	SystemSettings.IsControlCurrent=0;
	SystemSettings.PercentLoad=0;
	SystemSettings.IsTestStarted=0;

	//Init Button
	Button.OK=0;
	Button.C=0;
	Button.B1=0;
	Button.B2=0;
	Button.CounterB1=0;
	Button.CounterB2=0;

	//Reset PWM
	TIM1->CCR1=0;
	TIM1->CCR2=0;
	TIM1->CCR3=0;
}
//**************************************************************************************
