edosedgar/ATX_PS/(commit log)

2015-09-19 Upload whole project about development testing system for ATX12V Power Supply
    [5V; 3,3V channels.lay6, ACS712.lay6, ATXBoard.lay6, GeneralBoard.lay6, STM32.lay6, Графики.xlsx, ИБП.lay6, Наклейки.lay6]
2015-11-03 Update status
    [5V; 3,3V channels.lay6, ACS712.lay6, ATXBoard.lay6, GeneralBoard.lay6, STM32.lay6, Графики.xlsx, ИБП.lay6, Наклейки.lay6]
